AstroDetlev/PiBook_on_AcerTravelMate4001/Keyboard/Keyboard_Matrix.xlsx

Sheet: Overview
 | 1 | 2 | 3 | 4 | 5 | 6 | 7 | 8 | 9 | 10 | 11 | 12 | 13 | 14 | 15 | 16 | 17 | 18 | 19 | 20 | 21 | 22 | 23 | 24
1
2
3
4
5
6 | F11 | Esc | F10 | Einfg | Ü
7 | F12 | ° | F9 | Entf | P
8
9 |  |  |  |  |  | $
10 | F8 | F5 | Backspace | Pos1 | Ä
11
12 | Q | Tab | 3 | BildAuf | Ö
13 |  |  |  |  |  | ß | 0 |  |  | o |  | I
14 |  |  |  |  |  |  | ` |  |  | * |  | Enter
15 |  |  |  |  |  | 7 | 6 |  |  | T |  | H
16 |  |  |  |  |  | 9 | 8 |  |  | U |  | Z
17 | F4 | F1 | 2 | BildAb | - |  |  | € |  |  | RightShift |  | L | # | G | J
18 |  |  |  |  |  | 5 | 4 |  |  | R |  | E |  |  |  |  | F
19
20
21 | F3 | F2 | Up | Right | : |  |  |  | RightCtrl |  | LeftShift |  | K | End | V | N |  | D
22 |  |  |  |  |  |  |  |  |  | W |  | S |  |  |  |  | A |  |  |  | Y
23 | F7 | F6 | Pause | Left |  |  |  |  | LeftCtrl |  |  |  | M | RightWin | Space |  |  | < | LeftWin | Alt |  | Fn
24 | 1 | CapsLock | Druck | Down |  |  |  |  |  |  |  |  | ; |  | C | B |  | X |  | AltGr
 | 8 | 8 | 8 | 8 | 6 | 5 | 5 | 1 | 2 | 6 | 2 | 6 | 4 | 3 | 4 | 3 | 2 | 3 | 1 | 2 | 1 | 1

Sheet: Positions
Esc | F1 | F2 | F3 | F4 | F5 | F6 | F7 | F8 | F9 | F10 | F11 | F12 | Druck | Pause | Einfg | Entf
° | 1 | 2 | 3 | 4 | 5 | 6 | 7 | 8 | 9 | 0 | ß | ´ | Backspace |  |  | Pos1
Tab | Q | W | E | R | T | Z | U | I | O | P | Ü | * | Enter |  |  | BildAuf
Capslock | A | S | D | F | G | H | J | K | L | Ö | Ä |  | # |  |  | BildAb
LeftShift | Y | X | C | V | B | N | M | ; | : | - | < | RightShift |  |  |  | End
LeftCtrl | Fn | LeftWin | Alt | Space | AltGr | RightWin | RightCtrl |  |  |  | € | Up | $
 |  |  |  |  |  |  |  |  |  |  | Left | Down | Right

Sheet: List
Key | Pins used | Row | Column
Esc | 2/6 | 2 | 6
F1 | 2/17 | 2 | 17
F2 | 2/21 | 2 | 21
F3 | 1/21 | 1 | 21
F4 | 1/17 | 1 | 17
F5 | 2/10 | 2 | 10
F6 | 2/23 | 2 | 23
F7 | 1/23 | 1 | 23
F8 | 1/10 | 1 | 10
F9 | 3/7 | 3 | 7
F10 | 3/6 | 3 | 6
F11 | 1/6 | 1 | 6
F12 | 1/7 | 1 | 7
Druck | 3/24 | 3 | 24
Pause | 3/23 | 3 | 23
Einfg | 4/6 | 4 | 6
Entf | 4/7 | 4 | 7
° | 2/7 | 2 | 7
1 | 1/24 | 1 | 24
2 | 3/17 | 3 | 17
3 | 3/12 | 3 | 12
4 | 7/18 | 7 | 18
5 | 6/18 | 6 | 18
6 | 7/15 | 7 | 15
7 | 6/15 | 6 | 15
8 | 7/16 | 7 | 16
9 | 6/16 | 6 | 16
0 | 7/13 | 7 | 13
ß | 6/13 | 6 | 13
' | 7/14 | 7 | 14
Backspace | 3/10 | 3 | 10
Pos1 | 4/10 | 4 | 10
Tab | 2/12 | 2 | 12
Q | 1/12 | 1 | 12
W | 10/22 | 10 | 22
E | 12/18 | 12 | 18
R | 10/18 | 10 | 18
T | 10/15 | 10 | 15
Z | 12/16 | 12 | 16
U | 10/16 | 10 | 16
I | 12/13 | 12 | 13
O | 10/13 | 10 | 13
P | 5/7 | 5 | 7
Ü | 5/6 | 5 | 6
* | 10/14 | 10 | 14
Enter | 12/14 | 12 | 14
BildAuf | 4/12 | 4 | 12
CapsLock | 2/24 | 2 | 24
A | 17/22 | 17 | 22
S | 12/22 | 12 | 22
D | 18/21 | 18 | 21
F | 17/18 | 17 | 18
G | 15/17 | 15 | 17
H | 12/15 | 12 | 15
J | 16/17 | 16 | 17
K | 13/21 | 13 | 21
L | 13/17 | 13 | 17
Ö | 5/12 | 5 | 12
Ä | 5/10 | 5 | 10
# | 14/17 | 14 | 17
BildAb | 4/17 | 4 | 17
LeftShift | 11/21 | 11 | 21
Y | 21/22 | 21 | 22
X | 18/24 | 18 | 24
C | 15/24 | 15 | 24
V | 15/21 | 15 | 21
B | 16/24 | 16 | 24
N | 16/21 | 16 | 21
M | 13/23 | 13 | 23
; | 13/24 | 13 | 24
: | 5/21 | 5 | 21
- | 5/17 | 5 | 17
< | 18/23 | 18 | 23
RightShift | 11/17 | 11 | 17
End | 14/21 | 14 | 21
LeftCtrl | 9/23 | 9 | 23
Fn | 22/23 | 22 | 23
LeftWin | 19/23 | 19 | 23
Alt | 20/23 | 20 | 23
Space | 15/23 | 15 | 23
AltGr | 20/24 | 20 | 24
RightWin | 14/23 | 14 | 23
RightCtrl | 9/21 | 9 | 21
€ | 8/17 | 8 | 17
Up | 3/21 | 3 | 21
$ | 6/9 | 6 | 9
Left | 4/23 | 4 | 23
Down | 4/24 | 4 | 24
Right | 4/21 | 4 | 21

Sheet: Wiring
Arduino Mega 2560 Numbers as printed on PCB | Cable Adapter PCB: FPC-24P 1.0mm (There are two numberings. This is the numbering on the same PCB side as the connector)
22 | 1
23 | 2
24 | 3
25 | 4
26 | 5
27 | 6
28 | 7
29 | 8
30 | 9
31 | 10
32 | 11
33 | 12
34 | 13
35 | 14
36 | 15
37 | 16
38 | 17
39 | 18
40 | 19
41 | 20
42 | 21
43 | 22
44 | 23
45 | 24
