AstroDetlev/PiBook_on_AcerTravelMate4001/Keyboard/PS2_DETAILS.h

/*
#################################################################################
#################################################################################
##### PS/2 Codes and Commands (This is for Scan Code Set 2)
#################################################################################
#################################################################################
*/
/*
	Where I found all these details:
	http://www.marjorie.de
	https://www.eecg.utoronto.ca/~pc/courses/241/DE1_SoC_cores/ps2/ps2.html
	https://de.wikipedia.org/wiki/PS/2-Schnittstelle
	http://www.winfaq.de/faq_html/Content/tip1500/onlinefaq.php?h=tip1576.htm
*/
/*
#################################################################################
##### Keyboard to Host Commands
#################################################################################
*/
#define Ps2ScanCodeDummy 0x00  //Not a real scan code, just a dummy that will never be used on the wire

#define Ps2K2H_Acknowedge 		  0xFA
#define Ps2K2H_SelftestPassed 	0xAA
#define Ps2K2H_EchoResponse 	  0xEE
#define Ps2K2H_Resendrequest 	  0xFE
#define Ps2K2H_ErrorA			      0x00			
#define Ps2K2H_ErrorB			      0xFF


/*
#################################################################################
##### Host to Keyboard Commands
#################################################################################
*/

/*
Set status LEDs - This command can be used to turn on and off the Num Lock, Caps Lock and Scroll Lock LEDs. 
After receiving this command, the keyboard will reply with an ACK (FA) and wait for another byte which 
determines the status of the LEDs. 
Bit 0 controls the Scroll Lock, bit 1 controls the Num Lock and Bit 2 controls the Caps lock. Bits 3 to 7 are ignored.
*/
#define Ps2H2K_SetStatusLEDs 		0xED

/*
Echo - The keyboard should reply with an Echo (EE) upon receiving this command
*/
#define Ps2H2K_Echo 				    0xEE
/*
Set scan code set - Upon receiving F0, the keyboard will reply with an ACK (FA) and wait for another byte. 
This byte can be in the range 01 to 03, and it determines the scan code set to be used. 
Sending 00 as the second byte will return the scan code set currently in use.
*/
#define Ps2H2K_ScanCodeSet 		  0xF0

/*
Set repeat rate - The keyboard will acknowledge the command with an ACK (FA) and wait for the second byte 
which determines the repeat rate. 
*/
#define Ps2H2K_SetRepeatRate 		0xF3

/*
Keyboard Enable - Clears the output buffer, enables the keyboard (i.e., key codes will be transmitted) 
and returns an ACK.
*/
#define Ps2H2K_KeyboardEnable 		0xF4

/*
Keyboard Disable - Resets the keyboard, disables the keyboard 
(key codes will not be transmitted) and returns an ACK.
*/
#define Ps2H2K_KeyboardDisable 		0xF5

/*
Resend - Upon receipt of the resend command the keyboard will retransmit the last byte sent.
*/
#define Ps2H2K_Resend 		0xFE

/*
Reset - Resets the keyboard.
*/
#define Ps2H2K_Reset 		0xFF

/*
Makecodes
*/
#define Ps2Mk_ESC 				0x76 
#define Ps2Mk_F1 				  0x05 
#define Ps2Mk_F2 				  0x06 
#define Ps2Mk_F3 				  0x04 
#define Ps2Mk_F4 				  0x0C 
#define Ps2Mk_F5 				  0x03 
#define Ps2Mk_F6 			  	0x0B 
#define Ps2Mk_F7 				  0x83 
#define Ps2Mk_F8 				  0x0A 
#define Ps2Mk_F9 				  0x01 
#define Ps2Mk_F10 				0x09 
#define Ps2Mk_F11 				0x78 
#define Ps2Mk_F12 				0x07 
#define Ps2Mk_PRINT				0xE0, 0x12, 0xE0, 0x7C 
#define Ps2Mk_SCROLL_LOCK 		0x7E 
#define Ps2Mk_BREAK 			0xE1, 0x14, 0x77, 0xE1, 0xF0, 0x14, 0xE0, 0x77 
#define Ps2Mk_CIRCUMFLEX				0x0E
#define Ps2Mk_1					0x16 
#define Ps2Mk_2					0x1E 
#define Ps2Mk_3					0x26 
#define Ps2Mk_4					0x25 
#define Ps2Mk_5					0x2E 
#define Ps2Mk_6					0x36 
#define Ps2Mk_7					0x3D 
#define Ps2Mk_8					0x3E 
#define Ps2Mk_9					0x46 
#define Ps2Mk_0					0x45

#define Ps2Mk_QUESTIONMARK		0x4E 
#define Ps2Mk_APOS				0x55 
#define Ps2Mk_BACKSPACE 		0x66 
#define Ps2Mk_TAB 				0x0D 
#define Ps2Mk_Q 				0x15 
#define Ps2Mk_W 				0x1D 
#define Ps2Mk_E 				0x24 
#define Ps2Mk_R 				0x2D 
#define Ps2Mk_T 				0x2C 
#define Ps2Mk_Z					0x35 
#define Ps2Mk_U 				0x3C 
#define Ps2Mk_I 				0x43 
#define Ps2Mk_O 				0x44 
#define Ps2Mk_P 				0x4D 
#define Ps2Mk_UE				0x54 
#define Ps2Mk_ASTERISK			0x5B 
#define Ps2Mk_SHARP				0x5D 
#define Ps2Mk_CAPS_LOCK 		0x58 
#define Ps2Mk_A 				0x1C 
#define Ps2Mk_S 				0x1B 
#define Ps2Mk_D 				0x23 
#define Ps2Mk_F 				0x2B 
#define Ps2Mk_G 				0x34 
#define Ps2Mk_H 				0x33 
#define Ps2Mk_J 				0x3B 
#define Ps2Mk_K 				0x42 
#define Ps2Mk_L 				0x4B 
#define Ps2Mk_OE				0x4C 
#define Ps2Mk_AE				0x52 
#define Ps2Mk_ENTER 			0x5A 
#define Ps2Mk_SHIFT_L 			0x12
#define Ps2Mk_LOWER_THAN 			0x61
 
#define Ps2Mk_Y					0x1A 
#define Ps2Mk_X 				0x22 
#define Ps2Mk_C 				0x21 
#define Ps2Mk_V 				0x2A 
#define Ps2Mk_B 				0x32 
#define Ps2Mk_N 				0x31 
#define Ps2Mk_M 				0x3A 
#define Ps2Mk_COMMA				0x41 
#define Ps2Mk_DOT				0x49 
#define Ps2Mk_MINUS				0x4A 
#define Ps2Mk_SHIFT_R			0x59 
#define Ps2Mk_CTRL_L 			0x14 
#define Ps2Mk_WIN_L 			    /*0xE0,*/ 0x1F 
#define Ps2Mk_ALT_L				0x11 
#define Ps2Mk_SPACE				0x29 
#define Ps2Mk_ALT_R 			    /*0xE0,*/ 0x11 
#define Ps2Mk_WIN_R 			    /*0xE0,*/ 0x27 
#define Ps2Mk_MENUS 			    /*0xE0,*/ 0x2F 
#define Ps2Mk_CTRL_R 			    /*0xE0,*/ 0x14
#define Ps2Mk_INSERT 			    /*0xE0,*/ 0x70 
#define Ps2Mk_HOME 				    /*0xE0,*/ 0x6C 
#define Ps2Mk_PAGE_UP 		    /*0xE0,*/ 0x7D 
#define Ps2Mk_DELETE 			    /*0xE0,*/ 0x71 
#define Ps2Mk_END 				    /*0xE0,*/ 0x69 
#define Ps2Mk_PAGE_DOWN 		  /*0xE0,*/ 0x7A 
#define Ps2Mk_ARROW_UP			  /*0xE0,*/ 0x75 
#define Ps2Mk_ARROW_LEFT 		  /*0xE0,*/ 0x6B 
#define Ps2Mk_ARROW_DOWN 		  /*0xE0,*/ 0x72 
#define Ps2Mk_ARROW_RIGHT 	  /*0xE0,*/ 0x74 

#define Ps2Mk_NUM_LOCK 			0x77 

#define Ps2Mk_NUMPAD_DIVIDE 	  /*0xE0,*/ 0x4A 
#define Ps2Mk_NUMPAD_MULTI		0x7C 
#define Ps2Mk_NUMPAD_MINUS		0x7B 
#define Ps2Mk_NUMPAD_7			0x6C 
#define Ps2Mk_NUMPAD_8			0x75 
#define Ps2Mk_NUMPAD_9			0x7D 
#define Ps2Mk_NUMPAD_PLUS 		0x79 
#define Ps2Mk_NUMPAD_4			0x6B 
#define Ps2Mk_NUMPAD_5			0x73 
#define Ps2Mk_NUMPAD_6			0x74 
#define Ps2Mk_NUMPAD_1			0x69 
#define Ps2Mk_NUMPAD_2			0x72 
#define Ps2Mk_NUMPAD_3			0x7A 
#define Ps2Mk_NUMPAD_0			0x70 
#define Ps2Mk_NUMPAD_DECIMAL 		0x71 
#define Ps2Mk_NUMPAD_ENTER 		  /*0xE0,*/ 0x5A 

//ACPI Scancodes
#define Ps2Mk_AcpiPower /*0xE0,*/ 0x37 
#define Ps2Mk_AcpiSleep /*0xE0,*/ 0x3f 
#define Ps2Mk_AcpiWake  /*0xE0,*/ 0x5e  

//Multimedia Scancodes 
#define Ps2Mk_MmNextTrack 		  /*0xE0,*/ 0x4d
#define Ps2Mk_MmPreviousTrack 	/*0xE0,*/ 0x15
#define Ps2Mk_MmStop 			      /*0xE0,*/ 0x3b
#define Ps2Mk_MmPlayPause 		  /*0xE0,*/ 0x34
#define Ps2Mk_MmMute 			      /*0xE0,*/ 0x23
#define Ps2Mk_MmVolumeUp 		    /*0xE0,*/ 0x32
#define Ps2Mk_MmVolumeDown 		  /*0xE0,*/ 0x21
#define Ps2Mk_MmMediaSelect 	  /*0xE0,*/ 0x50
#define Ps2Mk_MmEmail 			    /*0xE0,*/ 0x48
#define Ps2Mk_MmCalculator 		  /*0xE0,*/ 0x2b
#define Ps2Mk_MmMyComputer 		  /*0xE0,*/ 0x40
#define Ps2Mk_MmWwwSearch 		  /*0xE0,*/ 0x10
#define Ps2Mk_MmWwwHome 		    /*0xE0,*/ 0x3a
#define Ps2Mk_MmWwwBack 		    /*0xE0,*/ 0x38
#define Ps2Mk_MmWwwForward 		  /*0xE0,*/ 0x30
#define Ps2Mk_MmWwwStop 		    /*0xE0,*/ 0x28
#define Ps2Mk_MmWwwRefresh 		  /*0xE0,*/ 0x20
#define Ps2Mk_MmWwwFavorites 	  /*0xE0,*/ 0x18

  /*
  Makecode byte counts
  */
  #define Ps2MkBc_ESC 			1 
  #define Ps2MkBc_F1 				1 
  #define Ps2MkBc_F2 				1 
  #define Ps2MkBc_F3 				1 
  #define Ps2MkBc_F4 				1 
  #define Ps2MkBc_F5 				1 
  #define Ps2MkBc_F6 				1 
  #define Ps2MkBc_F7 				1 
  #define Ps2MkBc_F8 				1 
  #define Ps2MkBc_F9 				1 
  #define Ps2MkBc_F10 			1 
  #define Ps2MkBc_F11 			1 
  #define Ps2MkBc_F12 			1 
  #define Ps2MkBc_PRINT				      4 
  #define Ps2MkBc_SCROLL_LOCK 	1 
  #define Ps2MkBc_BREAK 				    8 
  #define Ps2MkBc_CIRCUMFLEX			1 
  #define Ps2MkBc_1				1 
  #define Ps2MkBc_2				1 
  #define Ps2MkBc_3				1 
  #define Ps2MkBc_4				1 
  #define Ps2MkBc_5				1 
  #define Ps2MkBc_6				1 
  #define Ps2MkBc_7				1 
  #define Ps2MkBc_8				1 
  #define Ps2MkBc_9				1 
  #define Ps2MkBc_0				1 
  #define Ps2MkBc_QUESTIONMARK	1 
  #define Ps2MkBc_APOS			1 
  #define Ps2MkBc_BACKSPACE 		1 
  #define Ps2MkBc_TAB 			1 
  #define Ps2MkBc_Q 				1 
  #define Ps2MkBc_W 				1 
  #define Ps2MkBc_E 				1 
  #define Ps2MkBc_R 				1 
  #define Ps2MkBc_T 				1 
  #define Ps2MkBc_Z				1 
  #define Ps2MkBc_U 				1 
  #define Ps2MkBc_I 				1 
  #define Ps2MkBc_O 				1 
  #define Ps2MkBc_P 				1 
  #define Ps2MkBc_UE				1 
  #define Ps2MkBc_ASTERISK		1 
  #define Ps2MkBc_SHARP			1 
  #define Ps2MkBc_CAPS_LOCK 		1 
  #define Ps2MkBc_A 				1 
  #define Ps2MkBc_S 				1 
  #define Ps2MkBc_D 				1 
  #define Ps2MkBc_F 				1 
  #define Ps2MkBc_G 				1 
  #define Ps2MkBc_H 				1 
  #define Ps2MkBc_J 				1 
  #define Ps2MkBc_K 				1 
  #define Ps2MkBc_L 				1 
  #define Ps2MkBc_OE				1 
  #define Ps2MkBc_AE				1 
  #define Ps2MkBc_ENTER 			1 
  #define Ps2MkBc_SHIFT_L 		1
  #define Ps2MkBc_LOWER_THAN 		1
  #define Ps2MkBc_Y				1 
  #define Ps2MkBc_X 				1 
  #define Ps2MkBc_C 				1 
  #define Ps2MkBc_V 				1 
  #define Ps2MkBc_B 				1 
  #define Ps2MkBc_N 				1 
  #define Ps2MkBc_M 				1 
  #define Ps2MkBc_COMMA			1 
  #define Ps2MkBc_DOT				1 
  #define Ps2MkBc_MINUS			1 
  #define Ps2MkBc_SHIFT_R			1 
  #define Ps2MkBc_CTRL_L 			1 
  #define Ps2MkBc_WIN_L 				2 
  #define Ps2MkBc_ALT_L			1 
  #define Ps2MkBc_SPACE			1 
  #define Ps2MkBc_ALT_R 				2 
  #define Ps2MkBc_WIN_R 				2 
  #define Ps2MkBc_MENUS 				2 
  #define Ps2MkBc_CTRL_R 				2 
  #define Ps2MkBc_INSERT 				2 
  #define Ps2MkBc_HOME 				2 
  #define Ps2MkBc_PAGE_UP 			2 
  #define Ps2MkBc_DELETE 				2 
  #define Ps2MkBc_END 				2
  #define Ps2MkBc_PAGE_DOWN 			2
  #define Ps2MkBc_ARROW_UP			2 
  #define Ps2MkBc_ARROW_LEFT 			2 
  #define Ps2MkBc_ARROW_DOWN 			2 
  #define Ps2MkBc_ARROW_RIGHT 		2 
  #define Ps2MkBc_NUM_LOCK 		1 
  #define Ps2MkBc_NUMPAD_DIVIDE 		2 
  #define Ps2MkBc_NUMPAD_MULTI	1 
  #define Ps2MkBc_NUMPAD_MINUS	1 
  #define Ps2MkBc_NUMPAD_7		1 
  #define Ps2MkBc_NUMPAD_8		1 
  #define Ps2MkBc_NUMPAD_9		1 
  #define Ps2MkBc_NUMPAD_PLUS 	1 
  #define Ps2MkBc_NUMPAD_4		1 
  #define Ps2MkBc_NUMPAD_5		1 
  #define Ps2MkBc_NUMPAD_6		1 
  #define Ps2MkBc_NUMPAD_1		1 
  #define Ps2MkBc_NUMPAD_2		1 
  #define Ps2MkBc_NUMPAD_3		1 
  #define Ps2MkBc_NUMPAD_0		1 
  #define Ps2MkBc_NUMPAD_DECIMAL 	1 
  #define Ps2MkBc_NUMPAD_ENTER 		2 

  //ACPI Scancodes
  #define Ps2MkBc_AcpiPower 2 
  #define Ps2MkBc_AcpiSleep 2
  #define Ps2MkBc_AcpiWake  2  

  //Multimedia Scancodes
  #define Ps2MkBc_MmNextTrack 		2
  #define Ps2MkBc_MmPreviousTrack 	2
  #define Ps2MkBc_MmStop 				2
  #define Ps2MkBc_MmPlayPause 		2
  #define Ps2MkBc_MmMute 				2
  #define Ps2MkBc_MmVolumeUp 			2
  #define Ps2MkBc_MmVolumeDown 		2
  #define Ps2MkBc_MmMediaSelect 		2
  #define Ps2MkBc_MmEmail 			2
  #define Ps2MkBc_MmCalculator 		2
  #define Ps2MkBc_MmMyComputer 		2
  #define Ps2MkBc_MmWwwSearch 		2
  #define Ps2MkBc_MmWwwHome 			2
  #define Ps2MkBc_MmWwwBack 			2
  #define Ps2MkBc_MmWwwForward 		2
  #define Ps2MkBc_MmWwwStop 			2
  #define Ps2MkBc_MmWwwRefresh 		2
  #define Ps2MkBc_MmWwwFavorites 		2

#define SCANCODE_1BYTE 0x01
#define SCANCODE_2BYTE 0x02

#define SCANID_MK_DUMMY 0x01
#define SCANID_MK_STD 0x02
#define SCANID_MK_SPCL 0x03
#define SCANID_MK_PRINT 0x04
#define SCANID_MK_BREAK 0x05

#define SCANID_BK_DUMMY 0x81
#define SCANID_BK_STD 0x82
#define SCANID_BK_SPCL 0x83
#define SCANID_BK_PRINT 0x84
