AstroDetlev/PiBook_on_AcerTravelMate4001/(commit log)

2021-12-20 Initial version of Arduino sketch for Accessing the keyboard matrix. - detects all keys - temporary output via UART
    [Keyboard_Matrix.xlsx]
2022-02-04 - Added macros for PS2 make/break scan codes (PS/2 scan code set 2). Currently not in use and probably not complete. - Names of some existing macros changed to have a better sync with the PS2 macro n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
    [ACER_TRAVELMATE4001WLMI_KEYBOARD_MATRIX.h, Keyboard.ino]
2022-02-05 - Some items renamed to get better matching names - Keyboard scanning is now "DetectPressedKeys", a separate function. (takes about 2ms) - state of each key is stored in an array. By compare before/a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
    [Keyboard.ino]
2022-02-09 - Keyboard detection: Code Cleanup and rewriting, time measuring - Wiring error found: Numbering of Keyboard connector PCB is printed on both sides, but they are not the same. 1 became 2, 2 became 1,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
    [ACER_TRAVELMATE4001WLMI_KEYBOARD_MATRIX.h, Keyboard.ino]
2022-02-11 - key detection is now extended by a layer to support the virtual keys made with "Fn" ToDo: If Fn is released, ALL Fn-based keys shall be released. Currently this happens at next time Fn is pressed.
2023-12-23 Add files via upload
    After a long break, this project continues.
    Keyboard buttons can be identified, but code chooses the wrong PS/2 scan code.
    Work in progress, not a release
    [ACER_TRAVELMATE4001WLMI_KEYBOARD_MATRIX.h, Keyboard.ino, PIN_ASSIGNMENTS.h, PS2_DETAILS.h]
2024-01-01 work in progress
    Some code for PS2dev added, Scan codes should be triggered now (untested)
    keyboard scan shows pressed buttons without a reason? Still work in progress
2024-01-01 Keyboard scan repaired, work in progress
    Keyboard scan repaired. It is time to wire the PS/2 part, connect it to an old PC and watch the bits and bytes via an oscilloscope. Work in progress.
2024-01-01 Key repeat implemented
    Key repeat implemented. Currently at a fix rate of 500ms. See KeyboardRepeatIntervalInMs
    [Keyboard.ino, PIN_ASSIGNMENTS.h]
2024-01-01 cleared Display_Controller.h
    currently not in use
2024-01-04 Key repeat fixed
    Key repeat did not work if key is pressed very short.
    Debug messages modified
    [ACER_TRAVELMATE4001WLMI_KEYBOARD_MATRIX.h, Display_Controller.h, Keyboard.ino, PIN_ASSIGNMENTS.h]
2024-01-04 Keyboard LEDs now react to PS/2 LED control byte
2024-01-04 A photo during the development
    The Keyboard matrix and everything else is mounted on a scrap board. The 8 LEDs are splitted in two groups: The 3 Keyboard LEDs and 5 LEDs that are a substitute for the buttons of the ScreenController.
2024-01-05 virtual NumPad issue fixed
    Beside from Numpad "Enter"-key, which is not available by design, the Numpad (blue lables on keys) is usable now
    [Keyboard_Matrix.xlsx]
2024-01-05 Multimedia and ACPI ScanCodes corrected
    Wrong codes in use, corrected. In addition, the Numpad code got an update
    [ACER_TRAVELMATE4001WLMI_KEYBOARD_MATRIX.h, Keyboard.ino, PS2_DETAILS.h]
2024-01-06 Keyboard with Teensy ++2.0 wired
2024-01-06 Teensy picture added
2024-01-06 Ready for Teensy ++2.0
    Teensy compiler uncovered some unused variables and a double used #define. Corrected.
    [Keyboard.ino, PIN_ASSIGNMENTS.h, PS2_DETAILS.h]
2024-01-07 Touchpad wiring added
